Ruben-MR/mewron_pwm2analog_daugtherboard/kicad/duet_dac.kicad_pcb

## KiCad design kicad/duet_dac.kicad_pcb (2026-06-29)

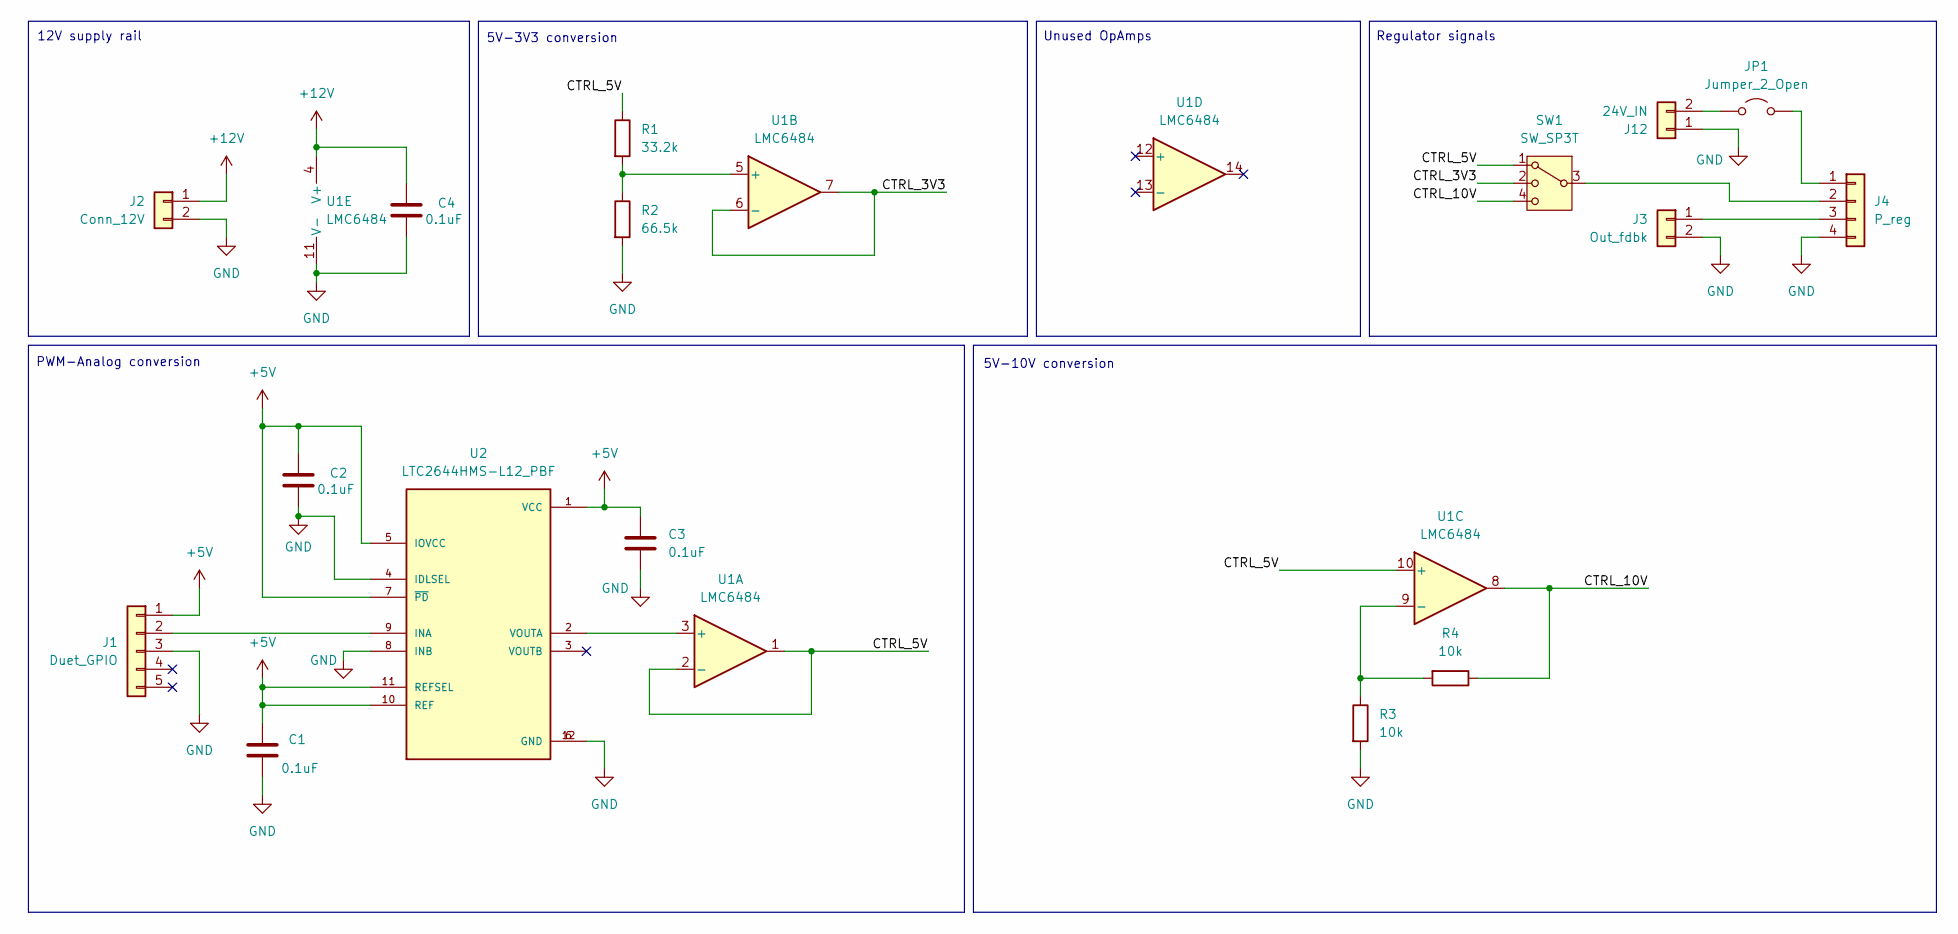
[picture p3: schematic duet_dac.kicad_sch, Duet DAC Schematic]

Parts:
C1, C2, C3, C4: 0.1uF; C_Rect_L4.0mm_W2.5mm_P2.50mm
J1: Duet_GPIO; Molex_KK-254_AE-6410-05A_1x05_P2.54mm_Vertical
J2: Conn_12V; Molex_KK-254_AE-6410-02A_1x02_P2.54mm_Vertical
J3: Out_fdbk; Molex_KK-254_AE-6410-02A_1x02_P2.54mm_Vertical
J4: P_reg; TerminalBlock_4Ucon_1x04_P3.50mm_Horizontal
J12: 24V_IN; Molex_KK-254_AE-6410-02A_1x02_P2.54mm_Vertical
JP1: Jumper_2_Open; PinHeader_1x02_P2.54mm_Vertical
R1: 33.2k; R_Axial_DIN0207_L6.3mm_D2.5mm_P7.62mm_Horizontal
R2: 66.5k; R_Axial_DIN0207_L6.3mm_D2.5mm_P7.62mm_Horizontal
R3, R4: 10k; R_Axial_DIN0207_L6.3mm_D2.5mm_P7.62mm_Horizontal
SW1: SW_SP3T; JSM07011
U1: LMC6484; SOIC-14_3.9x8.7mm_P1.27mm
U2: LTC2644HMS-L12_PBF; MSOP-12_3x4.039mm_P0.65mm; PARTREV B

Connections:
+5V: C1.1, C2.1, C3.1, J1.1, U2.1 (VCC), U2.5 (IOVCC), U2.7 (~PD), U2.10 (REF), U2.11 (REFSEL)
+12V: C4.1, J2.1, U1.4 (V+)
/CTRL_3V3: SW1.2, U1.6 (-), U1.7
/CTRL_5V: R1.1, SW1.1, U1.1, U1.2 (-), U1.10 (+)
/CTRL_10V: R4.1, SW1.4, U1.8
GND: C1.2, C2.2, C3.2, C4.2, J1.3, J2.2, J3.2, J4.4, J12.1, R2.2, R3.2, U1.11 (V-), U2.4 (IDLSEL), U2.6 (GND), U2.8 (INB), U2.12 (GND)
unnamed: J1.2, U2.9 (INA)
unnamed: J3.1, J4.3
unnamed: J4.1, JP1.2 (B)
unnamed: J4.2, SW1.3
unnamed: J12.2, JP1.1 (A)
unnamed: U1.3 (+), U2.2 (VOUTA)
unnamed: R1.2, R2.1, U1.5 (+)
unnamed: R3.1, R4.2, U1.9 (-)

Notes on the sheet:
5V-3V3 conversion
5V-10V conversion
Regulator signals
Unused OpAmps
12V supply rail
PWM-Analog conversion

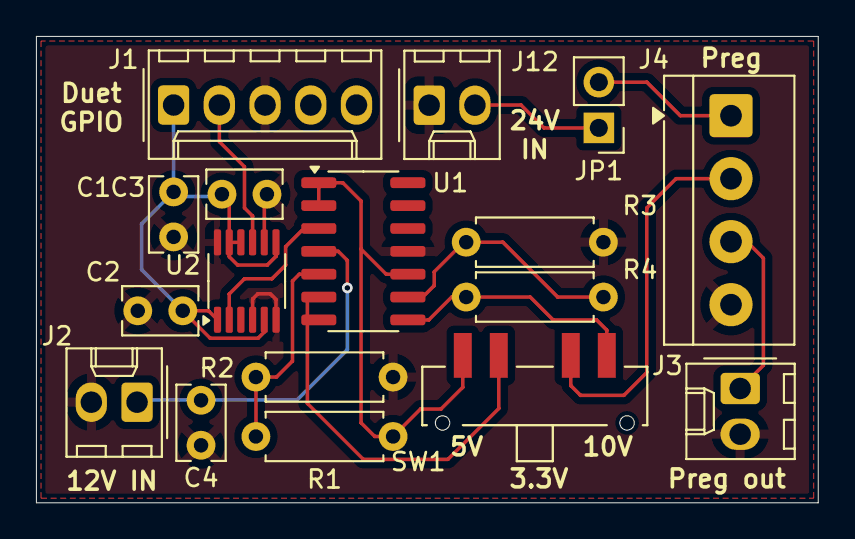
[picture p4: board duet_dac.kicad_pcb from above]

Board: 2 copper layers, 43.4 x 25.9 mm, 17 parts (0 on the bottom side), 14 nets.
